IbenCamerlynck/LineFollower/images/Bovenaanzicht robot.jpeg

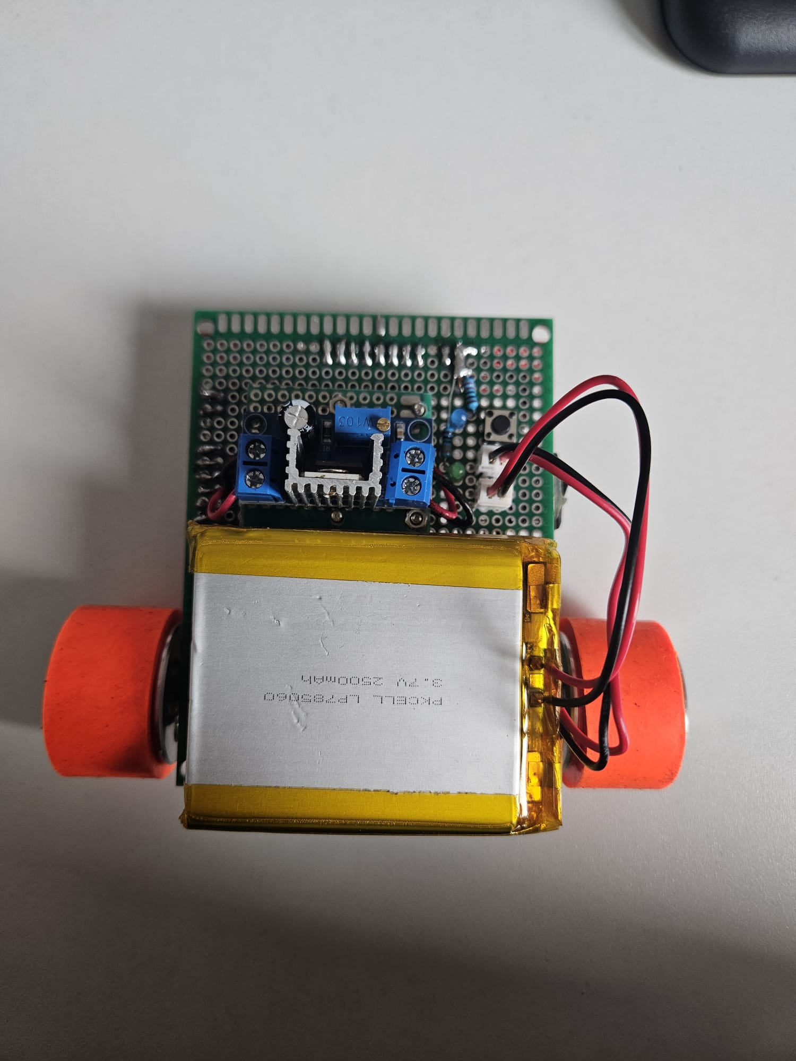
images/Bovenaanzicht robot.jpeg
