IbenCamerlynck/LineFollower/images/Onderkant robot.jpeg

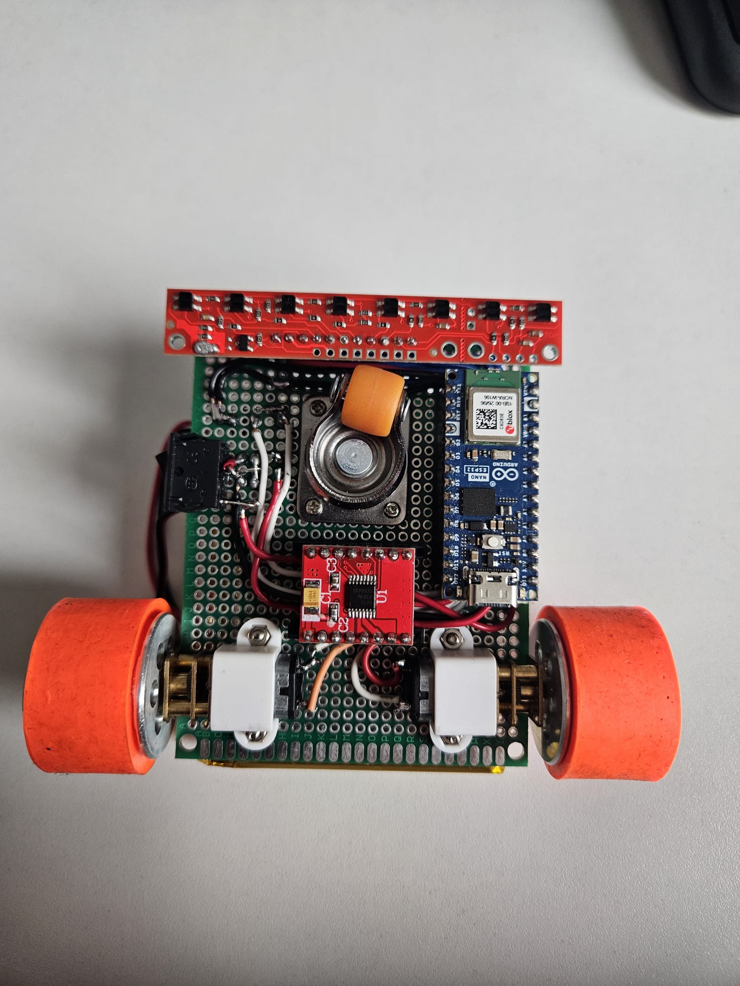
images/Onderkant robot.jpeg
