IbenCamerlynck/LineFollower/bill of materials/readme.md

## bill of materials
<br />

| volgnummer | naam | omschrijving | nieuw/recup | kostprijs/stuk (€) | aantal | subtotaal (€) |
|---:|---|---|---|---:|---:|---:|
| 1 | Motoren | [Open productlink](https://www.tinytronics.nl/nl/mechanica-en-actuatoren/motoren/dc-motoren/aslong-jga12-n20-30-dc-transmissiemotor-6v-500rpm) | Nieuw | 4,50 | 2 | 9,00 |
| 2 | Motorhouders | [Open productlink](https://nl.aliexpress.com/item/1005007026808685.html) | Nieuw | 0,46 | 2 | 0,92 |
| 3 | Batterijen | [Open productlink](https://www.tinytronics.nl/nl/power/batterijen/li-po/pkcell-li-po-batterij-3.7v-2500mah-jst-ph-lp785060) | Nieuw | 8,50 | 2 | 17,00 |
| 4 | Oplader batterijen | [Open productlink](https://www.tinytronics.nl/nl/power/bms-en-laders/li-ion-en-li-po/met-protectiecircuit/tp4056-micro-usb-li-ion-lader-1a-met-li-ion-protection-circuit) | Nieuw | 2,00 | 1 | 2,00 |
| 5 | Batterij connectoren | [Open productlink](https://nl.aliexpress.com/item/1005009149420159.html) | Nieuw | 0,10 | 4 | 0,40 |
| 6 | Spanningsregelaar | [Open productlink](https://www.tinytronics.nl/nl/power/spanningsconverters/spanningsregelaars/lm317-verstelbare-spanningsregelaar-module) | Nieuw | 2,50 | 1 | 2,50 |
| 7 | Motor driver | [Open productlink](https://nl.aliexpress.com/item/1005006096143922.html) | Nieuw | 1,93 | 1 | 1,93 |
| 8 | Sensoren | [Open productlink](https://eu.robotshop.com/nl/products/pololu-qtr-8a-reflectiesensor-array?variant=42601052045480) | Nieuw | 14,24 | 1 | 14,24 |
| 9 | Arduino Nano ESP32 | [Open productlink](https://www.tinytronics.nl/nl/development-boards/microcontroller-boards/arduino-compatible/arduino-nano-esp32-esp32-s3) | Nieuw | 21,00 | 1 | 21,00 |
| 10 | Wielen | [Open productlink](https://eu.robotshop.com/nl/products/slt20-aluminium-siliconen-wiel-33-x-20-mm-paar?variant=42980151525544) | Nieuw | 12,10 | 1 | 12,10 |
| 11 | Zwenkwiel | [Open productlink](https://nl.aliexpress.com/item/1005012582526842.html) | Nieuw | 2,83 | 1 | 2,83 |
| 12 | Bekabeling | [Open productlink](https://nl.aliexpress.com/item/1005009667231656.html) | Nieuw | 0,62 | 1 | 0,62 |
| 13 | Weerstand 220 Ohm | [Open productlink](https://www.tinytronics.nl/nl/componenten/weerstanden/weerstanden/weerstand-220%CF%89-1-4w-10-stuks) | Nieuw | 0,05 | 3 | 0,15 |
| 14 | Leds (set) | [Open productlink](https://nl.aliexpress.com/item/1005011964189969.html) | Nieuw | 0,82 | 1 | 0,82 |
| 15 | Drukknop | [Open productlink](https://www.tinytronics.nl/nl/schakelaars/manuele-schakelaars/printplaatschakelaars/breadboard-tactile-pushbutton-switch-momentary-2pin-6*6*5mm) | Nieuw | 0,15 | 1 | 0,15 |
| 16 | Aan/Uit schakelaar | [Open productlink](https://www.tinytronics.nl/nl/schakelaars/manuele-schakelaars/wipschakelaars/standaard-inbouw-wipschakelaar-klein) | Nieuw | 0,45 | 1 | 0,45 |
| 17 | Pin headers (10 pinnen) | [Open productlink](https://www.tinytronics.nl/nl/kabels-en-connectoren/connectoren/pin-headers/female/10-pins-header-female) | Nieuw | 0,26 | 2 | 0,52 |
| 18 | Pin headers (15 pinnen) | [Open productlink](https://www.tinytronics.nl/nl/kabels-en-connectoren/connectoren/pin-headers/female/15-pins-header-female) | Nieuw | 0,31 | 3 | 0,93 |
| 19 | Protoboard | [Open productlink](https://www.tinytronics.nl/nl/gereedschap-en-montage/prototyping-toebehoren/experimenteer-printplaten/experimenteer-printplaat-7cm*9cm-dubbelzijdig) | Nieuw | 1,50 | 2 | 3,00 |
| | **Totale kostprijs robot** | | | | | **90,56** |
