IbenCamerlynck/LineFollower/code/proof of concepts/interrupt/Elektronisch schema start-stop interrupt proof of concept.pdf

## Batterij 1

## Batterij 2

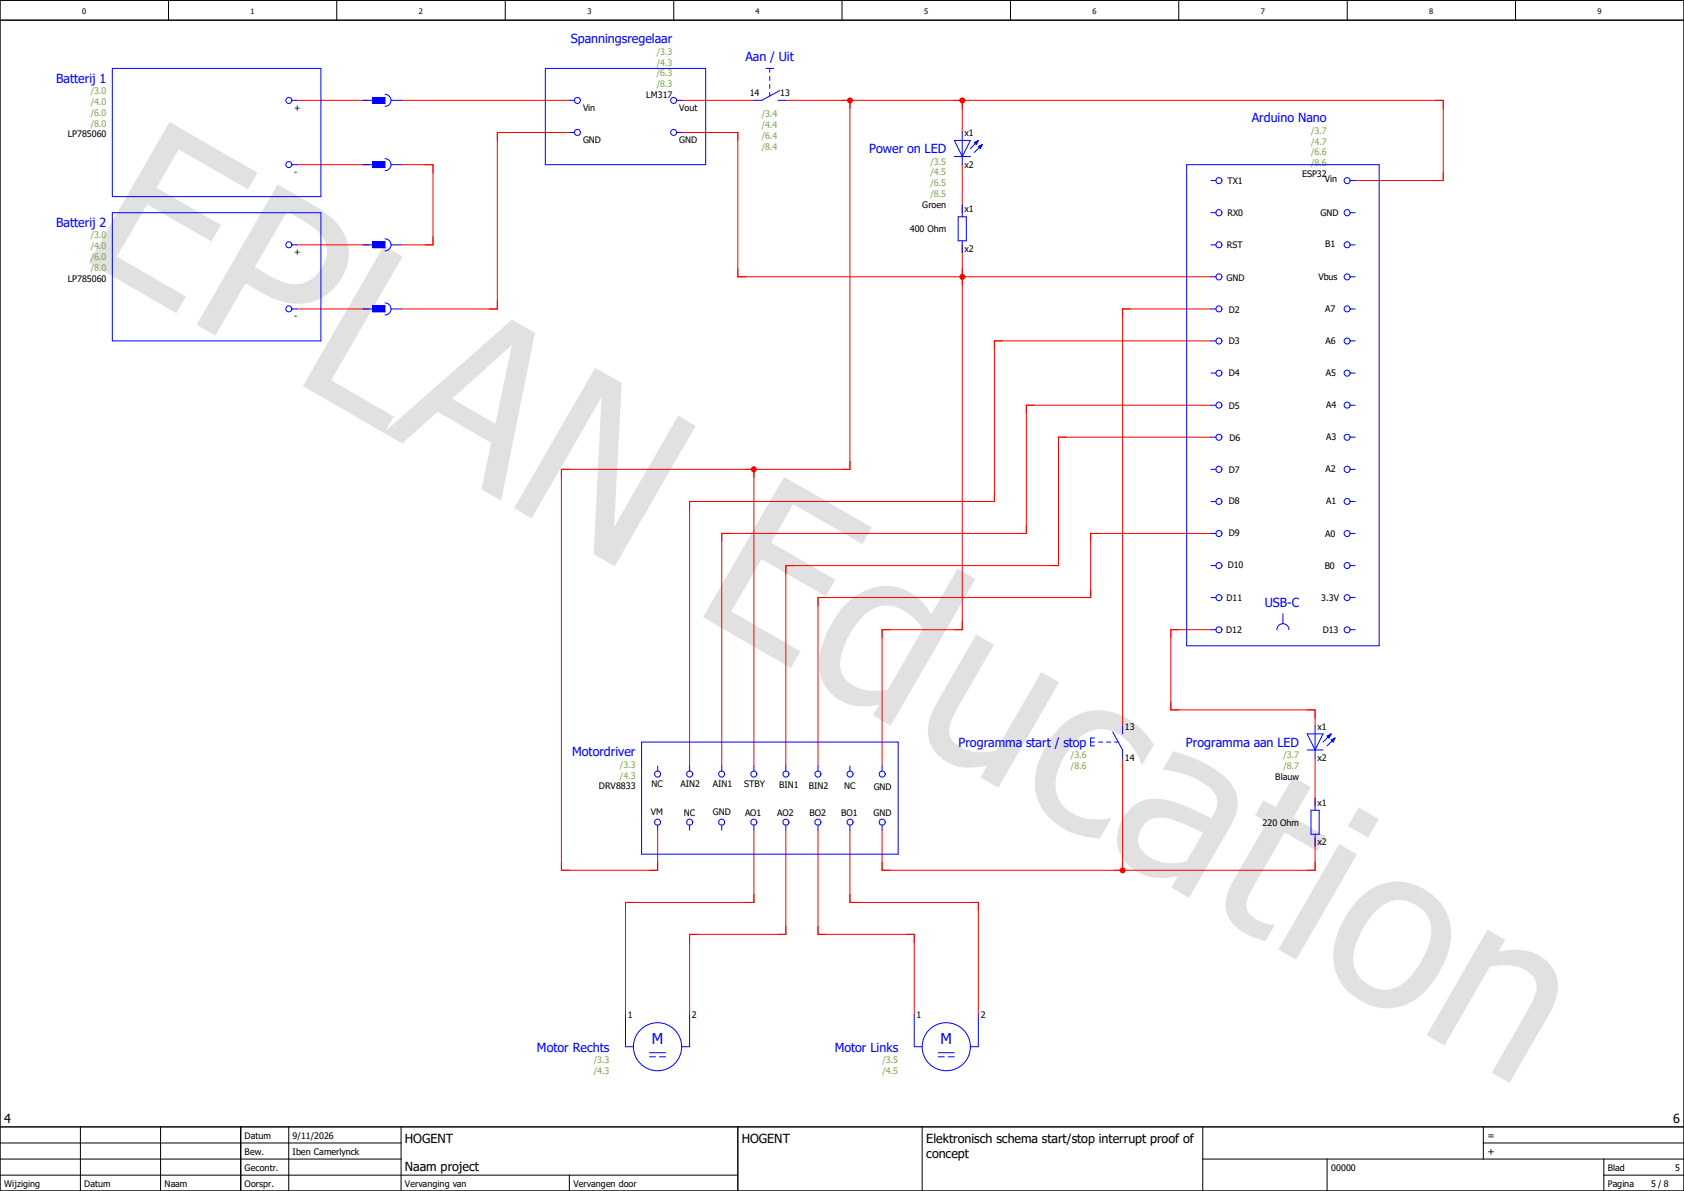
[picture p5: page 1]

Datum | 9/11/2026 | HOGENT Naam project | HOGENT | Elektronisch schema start/stop interrupt proof of concept | =
Bew. | Iben Camerlynck | | | | +
Gecontr. | | | | | 00000 | Blad 5

Wijziging | Datum | Naam | Oorspr. | | Vervanging van | Vervangen door | | | | Pagina 5 / 8
