IbenCamerlynck/LineFollower/code/proof of concepts/hbridge/Elektronisch schema H bridge proof of concept.pdf

## Batterij 1

## Batterij 2

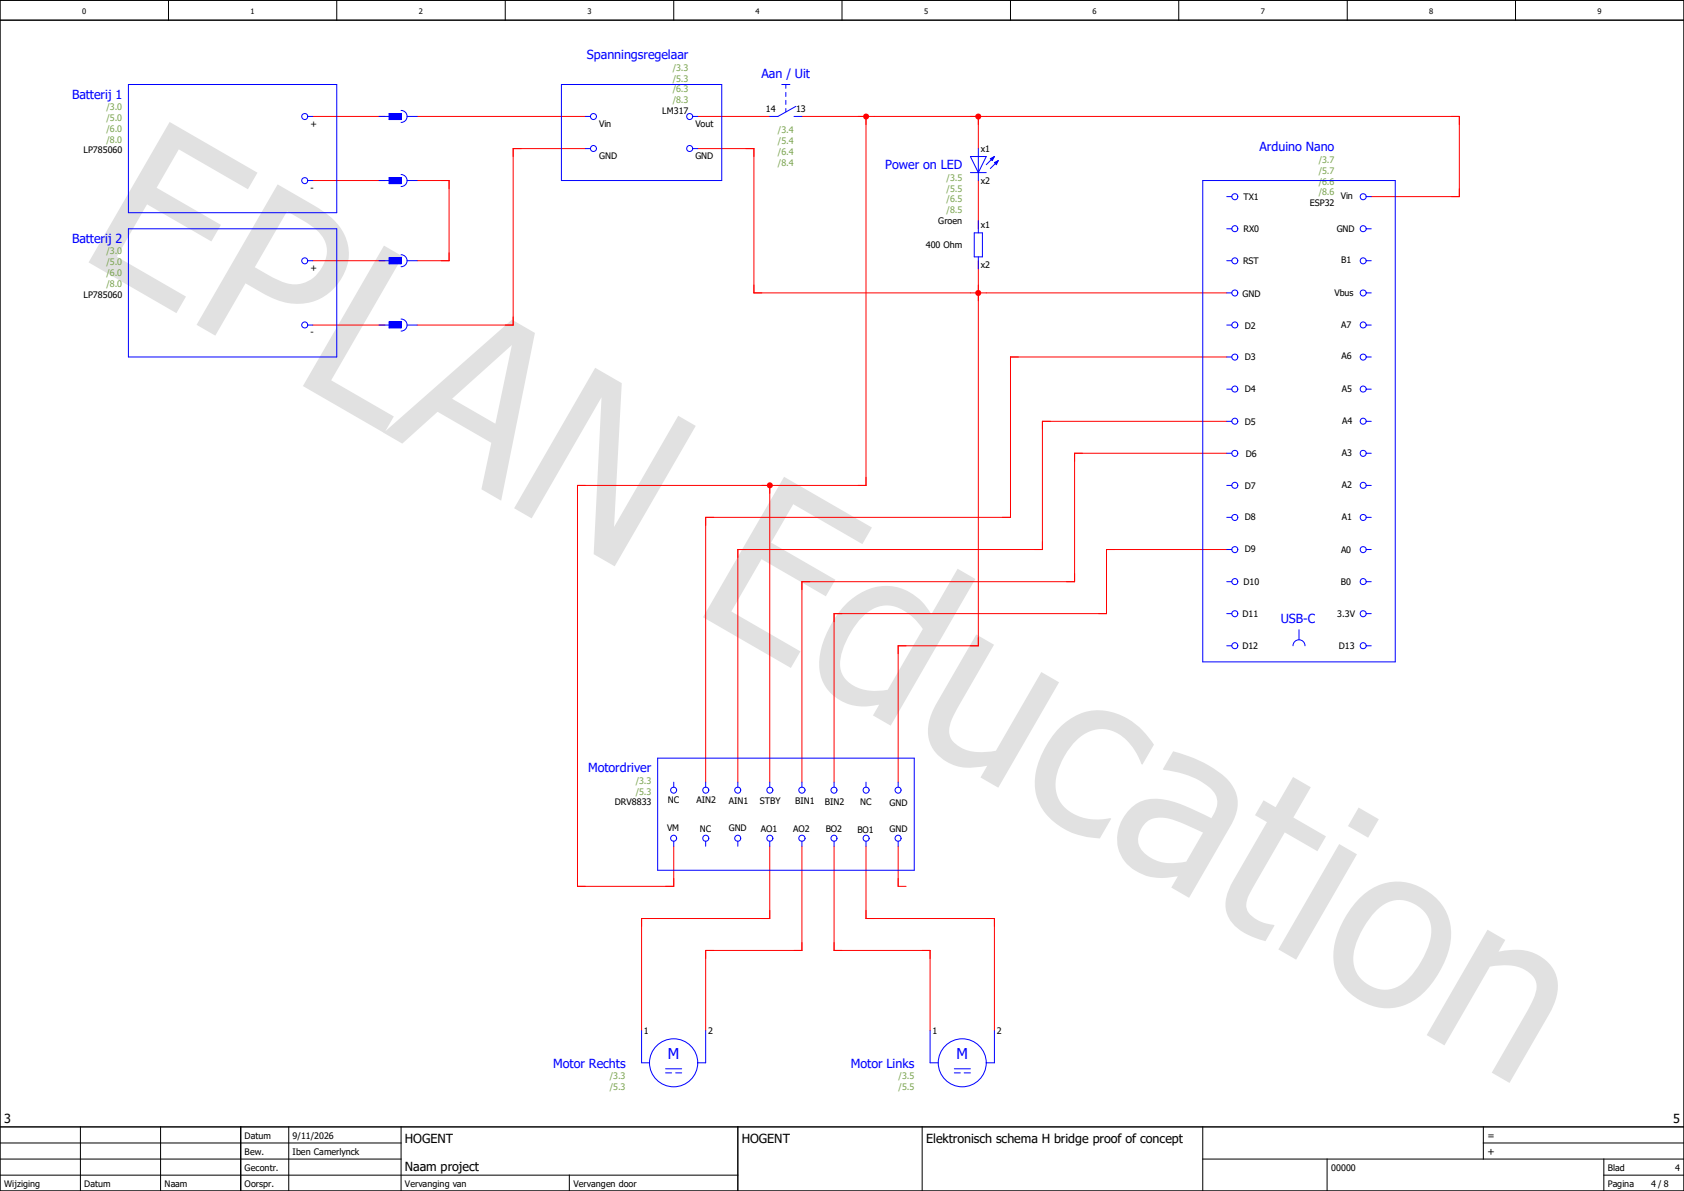
[picture p6: page 1]

Datum | 9/11/2026 | HOGENT Naam project | HOGENT | Elektronisch schema H bridge proof of concept | =
Bew. | Iben Camerlynck | | | | +
Gecontr. | | | | | 00000 | Blad 4

Wijziging | Datum | Naam | Oorspr. | | Vervanging van | Vervangen door | | | | Pagina 4 / 8
