IbenCamerlynck/LineFollower/code/proof of concepts/wireless communication/Elektronisch schema draadloze communicatie proof of concept.pdf

## Batterij 1

## Batterij 2

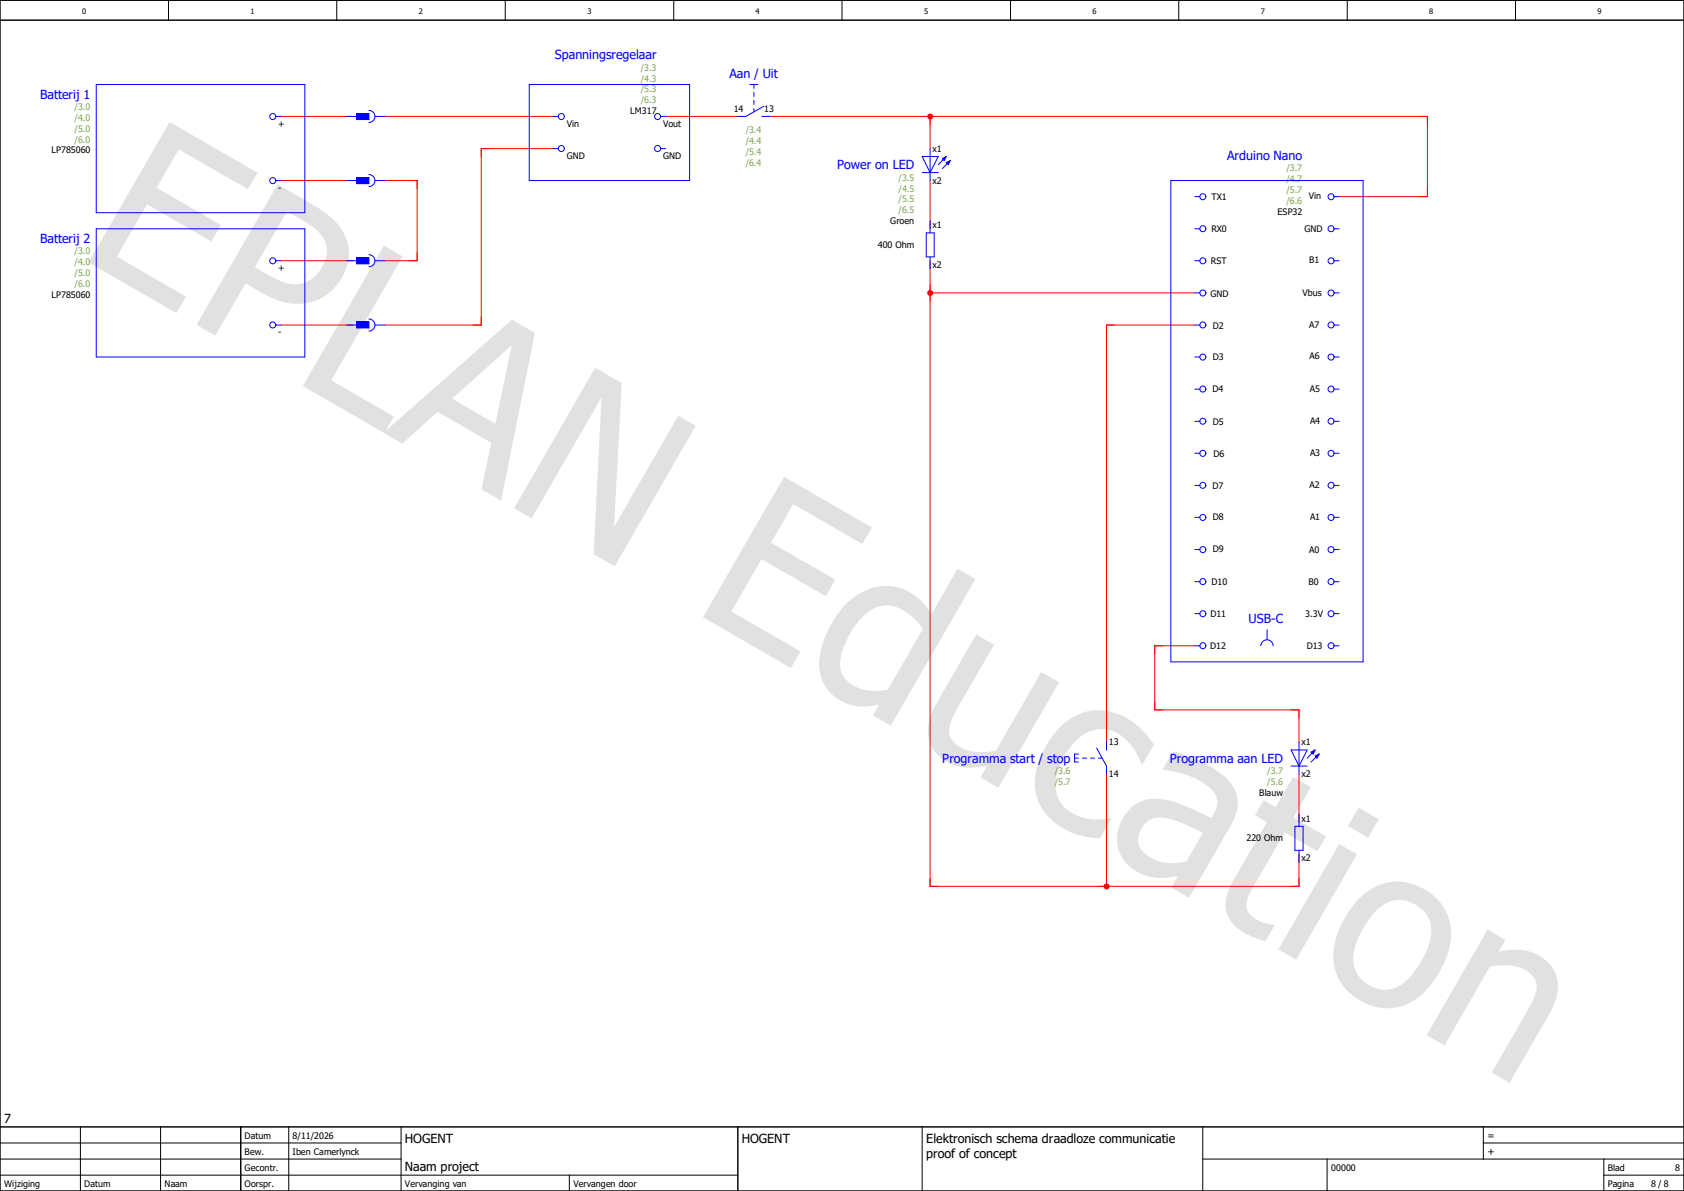
[picture p7: page 1]

Datum | 8/11/2026 | HOGENT Naam project | HOGENT | Elektronisch schema draadloze communicatie proof of concept | =
Bew. | Iben Camerlynck | | | | +
Gecontr. | | | | | 00000 | Blad 8

Wijziging | Datum | Naam | Oorspr. | | Vervanging van | Vervangen door | | | | Pagina 8 / 8
