IbenCamerlynck/LineFollower/technische tekeningen/elektronisch/Elektronisch schema V4.pdf

## Batterij 1

## Batterij 2

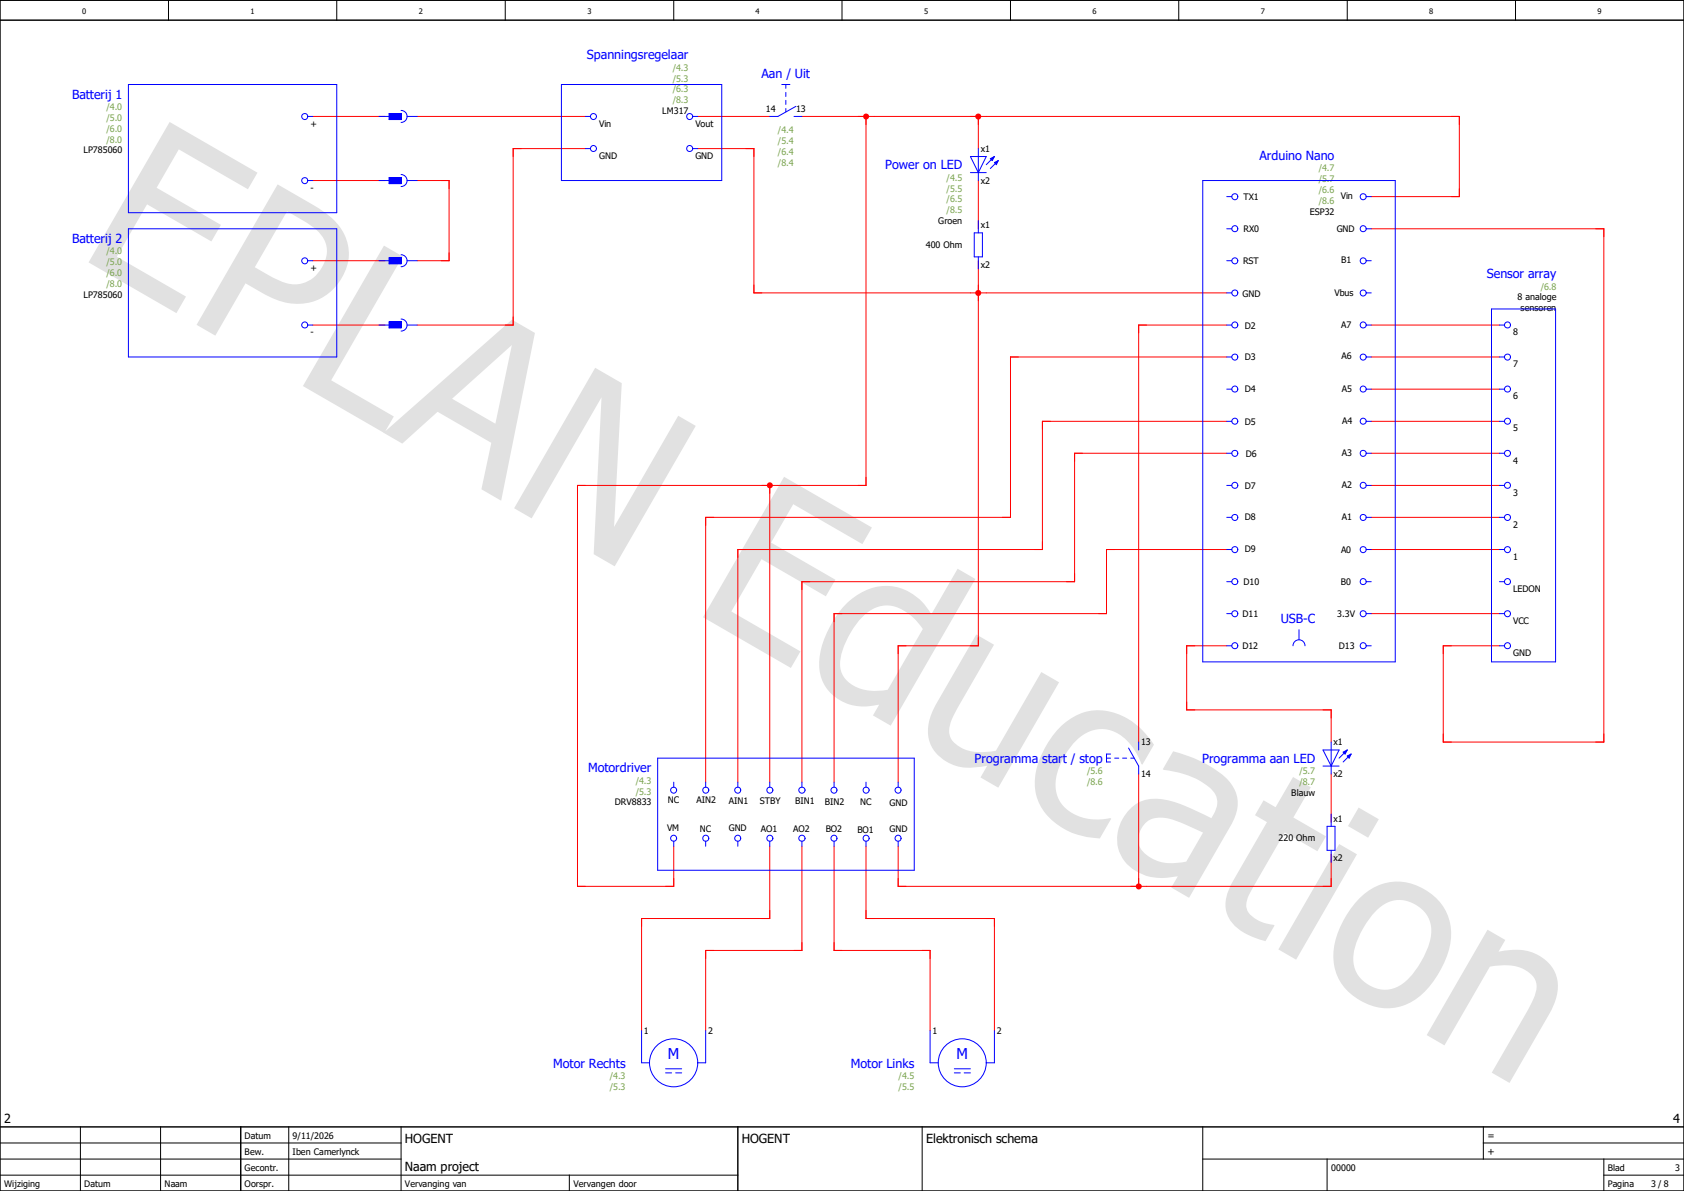
[picture p8: page 1]

Datum | 9/11/2026 | HOGENT Naam project | HOGENT | Elektronisch schema | =
Bew. | Iben Camerlynck | | | | +
Gecontr. | | | | | 00000 | Blad 3

Wijziging | Datum | Naam | Oorspr. | | Vervanging van | Vervangen door | | | | Pagina 3 / 8
