IbenCamerlynck/LineFollower/(commit log)

2026-10-26 Update readme with bill of materials
    Added detailed bill of materials with product links and pricing.
2026-11-08 Revise readme with comprehensive usage instructions
    Updated the readme with detailed instructions for charging batteries, wireless communication, commands, calibration, and settings.
